rarepotato8de/RoRo60/hardware/hotswap/RoRo60HS.kicad_sch

## KiCad design hardware/hotswap/RoRo60HS.kicad_sch (2026-01-02)

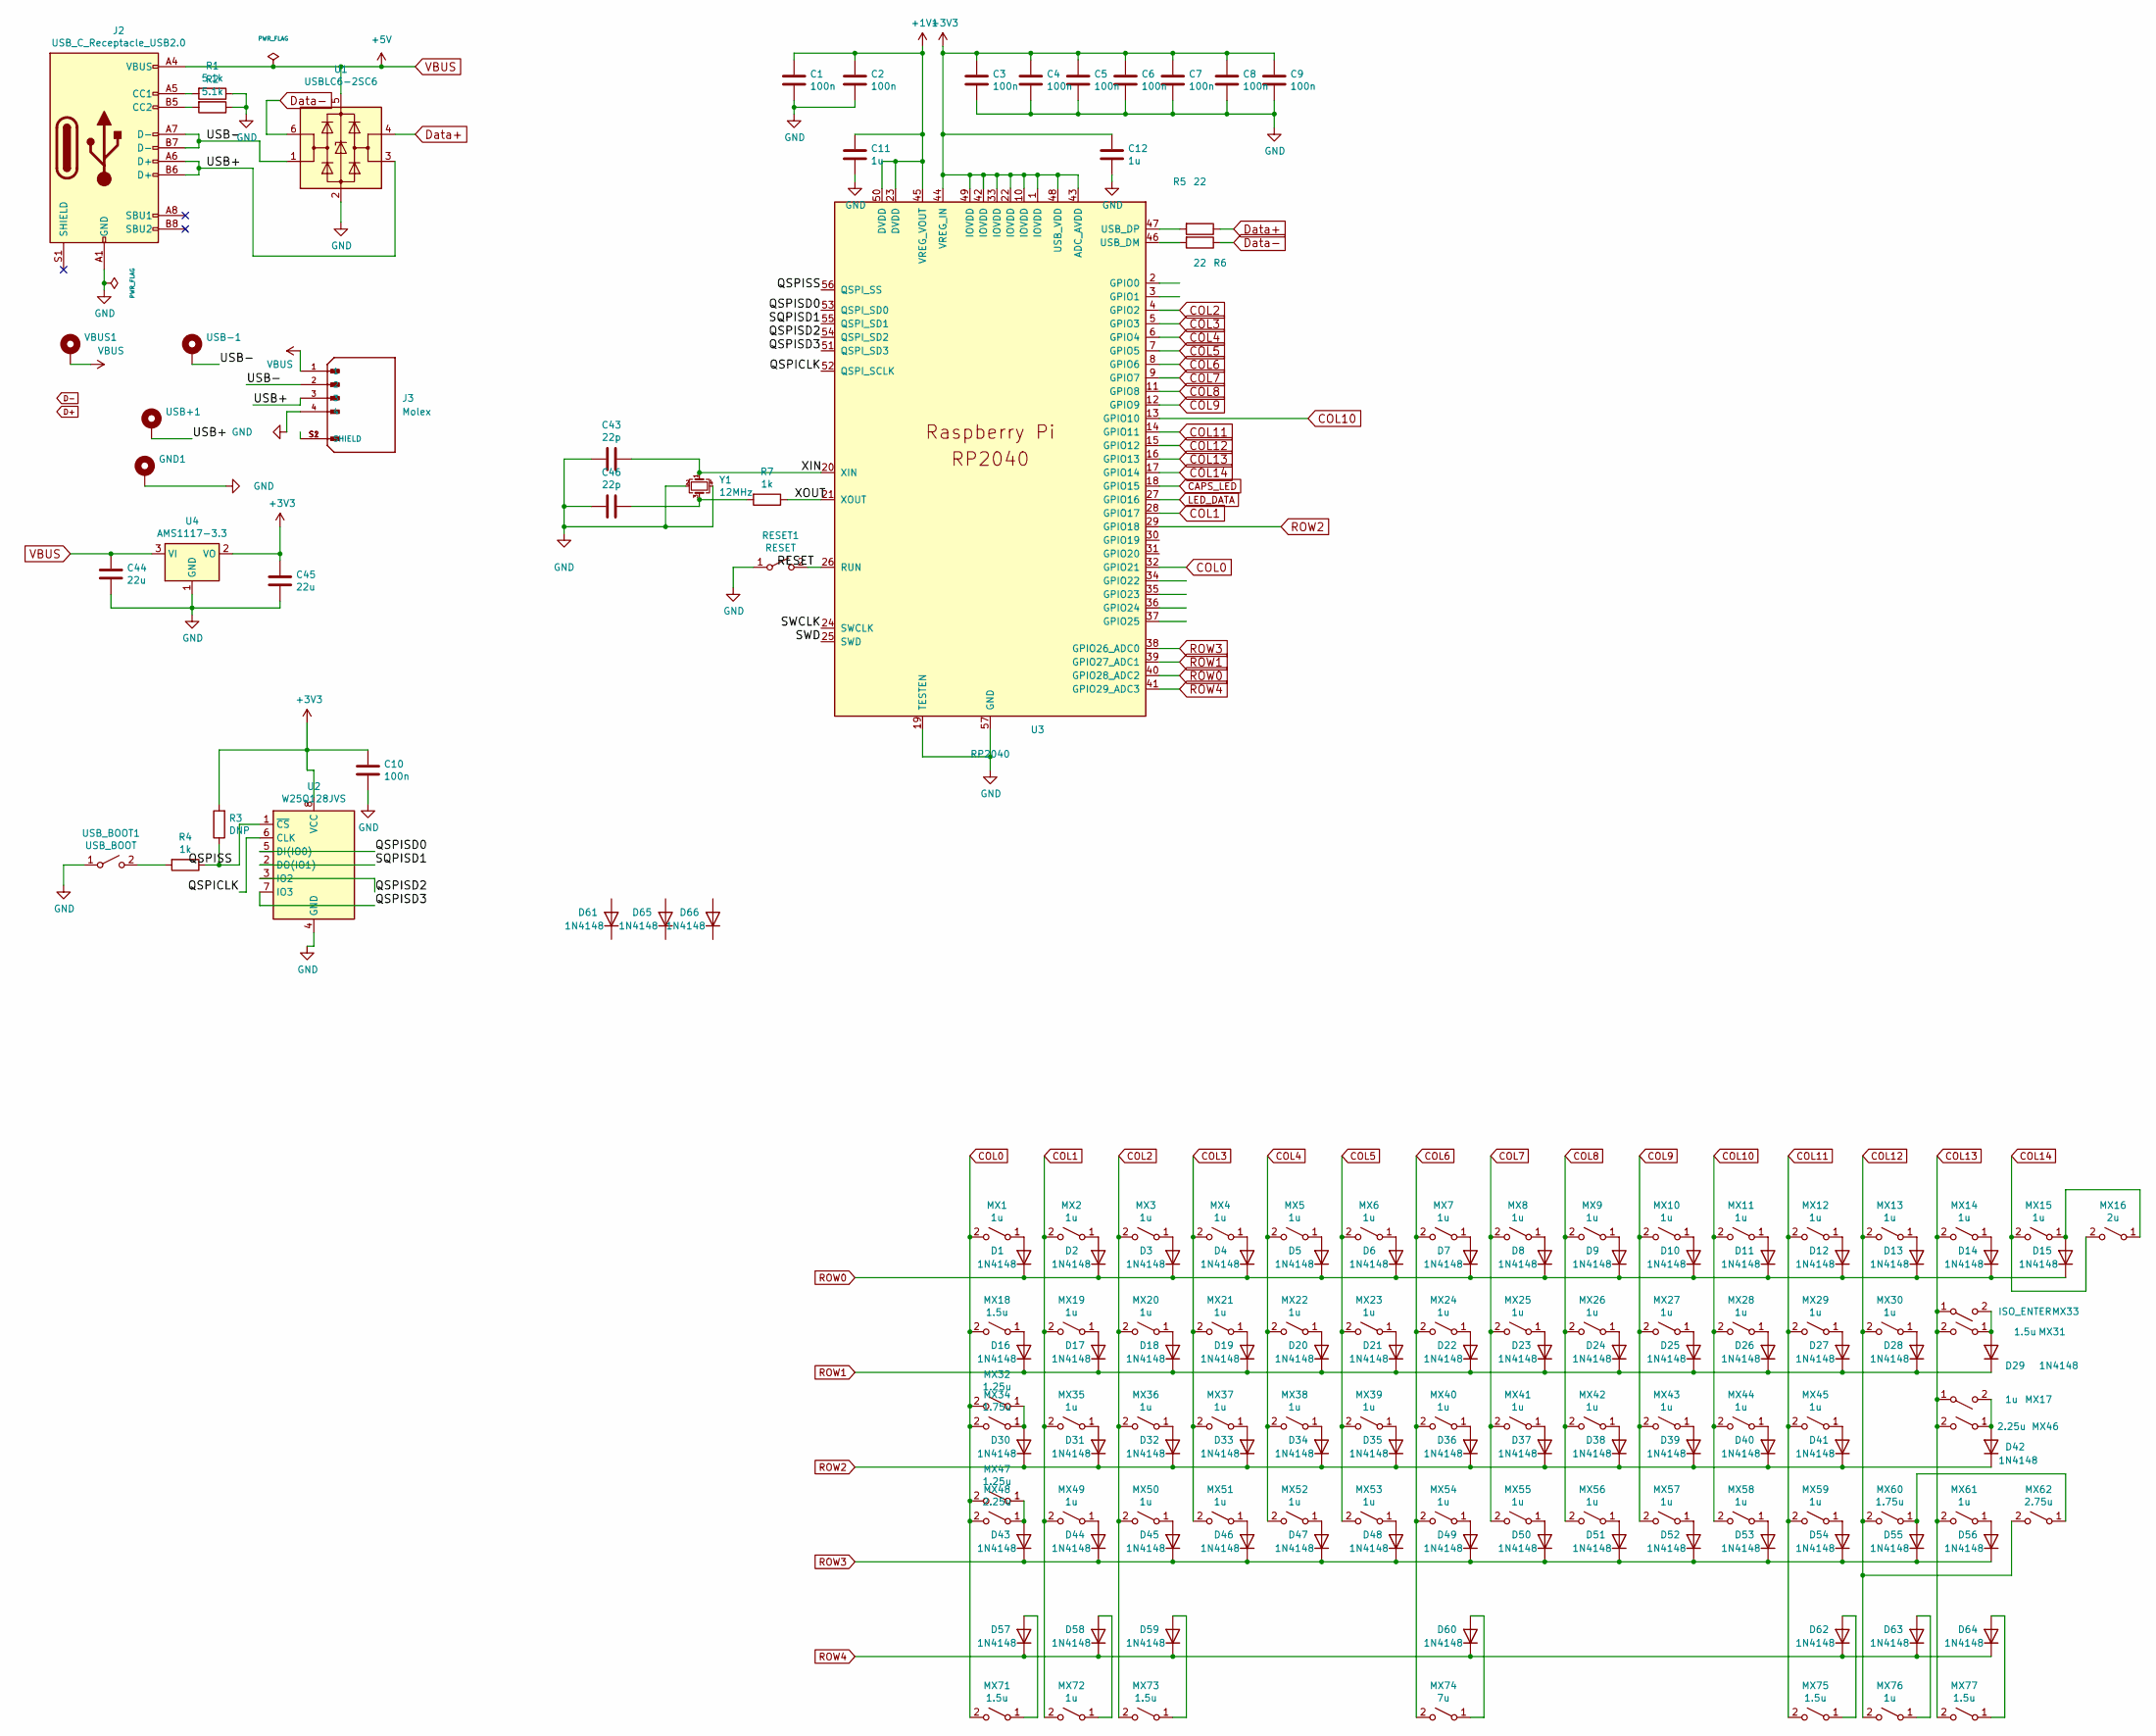
[picture p1: schematic RoRo60HS.kicad_sch]

Parts:
C1, C2, C3, C4, C5, C6, C7, C8, C9, C10: 100n; C_0603_1608Metric; LCSC C14663
C11, C12: 1u; C_0603_1608Metric; LCSC C15849
C43, C46: 22p; C_0603_1608Metric; LCSC C1653
C44, C45: 22u; C_0603_1608Metric; LCSC C59461
D1, D2, D3, D4, D5, D6, D7, D8, D9, D10, D11, D12, D13, D14, D15, D16, D17, D18, D19, D20, D21, D22, D23, D24, D25, D26, D27, D28, D29, D30, D31, D32, D33, D34, D35, D36, D37, D38, D39, D40, D41, D42, D43, D44, D45, D46, D47, D48, D49, D50, D51, D52, D53, D54, D55, D56, D57, D58, D59, D60, D61, D62, D63, D64, D65, D66: 1N4148; D_SOD-123; LCSC Part # C81598
GND1: MountingHole_Pad; SMD
J2: USB_C_Receptacle_USB2.0; USB_C_Receptacle_GCT_USB4085
J3: Molex; MOLEX_0781710004; PARTREV G
MX1, MX2, MX3, MX4, MX5, MX6, MX7, MX8, MX9, MX10, MX11, MX12, MX13, MX14, MX15, MX17, MX19, MX20, MX21, MX22, MX23, MX24, MX25, MX26, MX27, MX28, MX29, MX30, MX35, MX36, MX37, MX38, MX39, MX40, MX41, MX42, MX43, MX44, MX45, MX49, MX50, MX51, MX52, MX53, MX54, MX55, MX56, MX57, MX58, MX59, MX61, MX72, MX76: 1u; MXOnly-1U-Hotswap
MX16: 2u; MXOnly-2U-Hotswap
MX18, MX31, MX71, MX73, MX75, MX77: 1.5u; MXOnly-1.5U-Hotswap
MX32, MX47: 1.25u; MXOnly-1.25U-Hotswap
MX33: ISO_ENTER; MXOnly-ISO-Hotswap-ReversedStabilizers
MX34, MX60: 1.75u; MXOnly-1.75U-Hotswap
MX46, MX48: 2.25u; MXOnly-2.25U-Hotswap
MX62: 2.75u; MXOnly-2.75U-Hotswap
MX74: 7u; MXOnly-7U-Hotswap-ReversedStabilizers
R1, R2: 5.1k; R_0603_1608Metric; LCSC C23186
R3: DNP; R_0603_1608Metric
R4, R7: 1k; R_0603_1608Metric; LCSC C21190
R5, R6: 22; R_0603_1608Metric; LCSC C23345
RESET1: RESET; SW_SPST_TL3342; LCSC C318884
U1: USBLC6-2SC6; SOT-23-6; LCSC C558442
U2: W25Q128JVS; SOIC-8_5.23x5.23mm_P1.27mm; LCSC C97521
U3: RP2040; RP2040-QFN-56; LCSC C2040
U4: AMS1117-3.3; SOT-223-3_TabPin2; LCSC C6186
USB+1: MountingHole_Pad; SMD
USB-1: MountingHole_Pad; SMD
USB_BOOT1: USB_BOOT; SW_SPST_TL3342; LCSC C318884
VBUS1: MountingHole_Pad; SMD
Y1: 12MHz; Crystal_SMD_3225-4Pin_3.2x2.5mm; LCSC C518158

Connections:
+1V1: C1.1, C2.1, C11.1, U3.23 (DVDD), U3.45 (VREG_VOUT), U3.50 (DVDD)
+3V3: C3.1, C4.1, C5.1, C6.1, C7.1, C8.1, C9.1, C10.1, C12.1, C45.1, R3.2, U2.8 (VCC), U3.1 (IOVDD), U3.10 (IOVDD), U3.22 (IOVDD), U3.33 (IOVDD), U3.42 (IOVDD), U3.43 (ADC_AVDD), U3.44 (VREG_IN), U3.48 (USB_VDD), U3.49 (IOVDD), U4.2 (VO)
+5V: C44.1, J2.A4 (VBUS), J2.A9 (VBUS), J2.B4 (VBUS), J2.B9 (VBUS), U1.5 (VBUS), U4.3 (VI)
CAPS_LED: U3.18 (GPIO15)
COL0: MX1.2 (B), MX18.2 (B), MX32.2 (B), MX34.2 (B), MX47.2 (B), MX48.2 (B), MX71.2 (B), U3.32 (GPIO21)
COL1: MX2.2 (B), MX19.2 (B), MX35.2 (B), MX49.2 (B), MX72.2 (B), U3.28 (GPIO17)
COL2: MX3.2 (B), MX20.2 (B), MX36.2 (B), MX50.2 (B), MX73.2 (B), U3.4 (GPIO2)
COL3: MX4.2 (B), MX21.2 (B), MX37.2 (B), MX51.2 (B), U3.5 (GPIO3)
COL4: MX5.2 (B), MX22.2 (B), MX38.2 (B), MX52.2 (B), U3.6 (GPIO4)
COL5: MX6.2 (B), MX23.2 (B), MX39.2 (B), MX53.2 (B), U3.7 (GPIO5)
COL6: MX7.2 (B), MX24.2 (B), MX40.2 (B), MX54.2 (B), MX74.2 (B), U3.8 (GPIO6)
COL7: MX8.2 (B), MX25.2 (B), MX41.2 (B), MX55.2 (B), U3.9 (GPIO7)
COL8: MX9.2 (B), MX26.2 (B), MX42.2 (B), MX56.2 (B), U3.11 (GPIO8)
COL9: MX10.2 (B), MX27.2 (B), MX43.2 (B), MX57.2 (B), U3.12 (GPIO9)
COL10: MX11.2 (B), MX28.2 (B), MX44.2 (B), MX58.2 (B), U3.13 (GPIO10)
COL11: MX12.2 (B), MX29.2 (B), MX45.2 (B), MX59.2 (B), MX75.2 (B), U3.14 (GPIO11)
COL12: MX13.2 (B), MX30.2 (B), MX60.2 (B), MX62.2 (B), MX76.2 (B), U3.15 (GPIO12)
COL13: MX14.2 (B), MX17.1 (A), MX31.2 (B), MX33.1 (A), MX46.2 (B), MX61.2 (B), MX77.2 (B), U3.16 (GPIO13)
COL14: MX15.2 (B), MX16.2 (B), U3.17 (GPIO14)
Data+: R5.1, U1.4 (I/O2)
Data-: R6.1, U1.6 (I/O1)
GND: C1.2, C2.2, C3.2, C4.2, C5.2, C6.2, C7.2, C8.2, C9.2, C10.2, C11.2, C12.2, C43.2, C44.2, C45.2, C46.2, GND1.1, J2.A1 (GND), J2.A12 (GND), J2.B1 (GND), J2.B12 (GND), J3.4, R1.1, R2.1, RESET1.1 (A), U1.2 (GND), U2.4 (GND), U3.19 (TESTEN), U3.57 (GND), U4.1 (GND), USB_BOOT1.1 (A), Y1.2, Y1.4
LED_DATA: U3.27 (GPIO16)
unnamed: C46.1, R7.2, Y1.3
unnamed: D1.2 (A), MX1.1 (A)
unnamed: D2.2 (A), MX2.1 (A)
unnamed: D3.2 (A), MX3.1 (A)
unnamed: D4.2 (A), MX4.1 (A)
unnamed: D5.2 (A), MX5.1 (A)
unnamed: D6.2 (A), MX6.1 (A)
unnamed: D7.2 (A), MX7.1 (A)
unnamed: D8.2 (A), MX8.1 (A)
unnamed: D9.2 (A), MX9.1 (A)
unnamed: D10.2 (A), MX10.1 (A)
unnamed: D11.2 (A), MX11.1 (A)
unnamed: D12.2 (A), MX12.1 (A)
unnamed: D13.2 (A), MX13.1 (A)
unnamed: D14.2 (A), MX14.1 (A)
unnamed: D15.2 (A), MX15.1 (A), MX16.1 (A)
unnamed: D16.2 (A), MX18.1 (A)
unnamed: D17.2 (A), MX19.1 (A)
unnamed: D18.2 (A), MX20.1 (A)
unnamed: D19.2 (A), MX21.1 (A)
unnamed: D20.2 (A), MX22.1 (A)
unnamed: D21.2 (A), MX23.1 (A)
unnamed: D22.2 (A), MX24.1 (A)
unnamed: D23.2 (A), MX25.1 (A)
unnamed: D24.2 (A), MX26.1 (A)
unnamed: D25.2 (A), MX27.1 (A)
unnamed: D26.2 (A), MX28.1 (A)
unnamed: D27.2 (A), MX29.1 (A)
unnamed: D28.2 (A), MX30.1 (A)
unnamed: D29.2 (A), MX31.1 (A), MX33.2 (B)
unnamed: D30.2 (A), MX32.1 (A), MX34.1 (A)
unnamed: D31.2 (A), MX35.1 (A)
unnamed: D32.2 (A), MX36.1 (A)
unnamed: D33.2 (A), MX37.1 (A)
unnamed: D34.2 (A), MX38.1 (A)
unnamed: D35.2 (A), MX39.1 (A)
unnamed: D36.2 (A), MX40.1 (A)
unnamed: D37.2 (A), MX41.1 (A)
unnamed: D38.2 (A), MX42.1 (A)
unnamed: D39.2 (A), MX43.1 (A)
unnamed: D40.2 (A), MX44.1 (A)
unnamed: D41.2 (A), MX45.1 (A)
unnamed: D42.2 (A), MX17.2 (B), MX46.1 (A)
unnamed: D43.2 (A), MX47.1 (A), MX48.1 (A)
unnamed: D44.2 (A), MX49.1 (A)
unnamed: D45.2 (A), MX50.1 (A)
unnamed: D46.2 (A), MX51.1 (A)
unnamed: D47.2 (A), MX52.1 (A)
unnamed: D48.2 (A), MX53.1 (A)
unnamed: D49.2 (A), MX54.1 (A)
unnamed: D50.2 (A), MX55.1 (A)
unnamed: D51.2 (A), MX56.1 (A)
unnamed: D52.2 (A), MX57.1 (A)
unnamed: D53.2 (A), MX58.1 (A)
unnamed: D54.2 (A), MX59.1 (A)
unnamed: D55.2 (A), MX60.1 (A), MX62.1 (A)
unnamed: D56.2 (A), MX61.1 (A)
unnamed: D57.2 (A), MX71.1 (A)
unnamed: D58.2 (A), MX72.1 (A)
unnamed: D59.2 (A), MX73.1 (A)
unnamed: D60.2 (A), MX74.1 (A)
unnamed: D62.2 (A), MX75.1 (A)
unnamed: D63.2 (A), MX76.1 (A)
unnamed: D64.2 (A), MX77.1 (A)
unnamed: J2.A5 (CC1), R1.2
unnamed: J2.B5 (CC2), R2.2
unnamed: J3.S1 (SHIELD), J3.S2 (SHIELD)
unnamed: R4.2, USB_BOOT1.2 (B)
unnamed: R5.2, U3.47 (USB_DP)
unnamed: R6.2, U3.46 (USB_DM)
QSPICLK: U2.6 (CLK), U3.52 (QSPI_SCLK)
QSPISD0: U2.5 (DI(IO0)), U3.53 (QSPI_SD0)
QSPISD2: U2.3 (IO2), U3.54 (QSPI_SD2)
QSPISD3: U2.7 (IO3), U3.51 (QSPI_SD3)
QSPISS: R3.1, R4.1, U2.1 (~CS), U3.56 (QSPI_SS)
RESET: RESET1.2 (B), U3.26 (RUN)
ROW0: D1.1 (K), D2.1 (K), D3.1 (K), D4.1 (K), D5.1 (K), D6.1 (K), D7.1 (K), D8.1 (K), D9.1 (K), D10.1 (K), D11.1 (K), D12.1 (K), D13.1 (K), D14.1 (K), D15.1 (K), U3.40 (GPIO28_ADC2)
ROW1: D16.1 (K), D17.1 (K), D18.1 (K), D19.1 (K), D20.1 (K), D21.1 (K), D22.1 (K), D23.1 (K), D24.1 (K), D25.1 (K), D26.1 (K), D27.1 (K), D28.1 (K), D29.1 (K), U3.39 (GPIO27_ADC1)
ROW2: D30.1 (K), D31.1 (K), D32.1 (K), D33.1 (K), D34.1 (K), D35.1 (K), D36.1 (K), D37.1 (K), D38.1 (K), D39.1 (K), D40.1 (K), D41.1 (K), D42.1 (K), U3.29 (GPIO18)
ROW3: D43.1 (K), D44.1 (K), D45.1 (K), D46.1 (K), D47.1 (K), D48.1 (K), D49.1 (K), D50.1 (K), D51.1 (K), D52.1 (K), D53.1 (K), D54.1 (K), D55.1 (K), D56.1 (K), U3.38 (GPIO26_ADC0)
ROW4: D57.1 (K), D58.1 (K), D59.1 (K), D60.1 (K), D62.1 (K), D63.1 (K), D64.1 (K), U3.41 (GPIO29_ADC3)
SQPISD1: U2.2 (DO(IO1)), U3.55 (QSPI_SD1)
SWCLK: U3.24 (SWCLK)
SWD: U3.25 (SWD)
USB+: J2.A6 (D+), J2.B6 (D+), J3.3, U1.3 (I/O2), USB+1.1
USB-: J2.A7 (D-), J2.B7 (D-), J3.2, U1.1 (I/O1), USB-1.1
VBUS: J3.1, VBUS1.1
XIN: C43.1, U3.20 (XIN), Y1.1
XOUT: R7.1, U3.21 (XOUT)
