rarepotato8de/RoRo60/firmware/v1_underglow/config.h

#pragma once

#include "config_common.h"

/* key matrix size */
#define MATRIX_ROWS 5
#define MATRIX_COLS 15
// ROWS: Top to bottom, COLS: Left to right

#define MATRIX_ROW_PINS { GP28, GP27, GP18, GP26, GP29 }
#define MATRIX_COL_PINS { GP21, GP17, GP2, GP3, GP4, GP5, GP6, GP7, GP8, GP9, GP10, GP11, GP12, GP13, GP14 }

#define RGB_DI_PIN GP16
#define RGBLED_NUM 10
#define WS2812_PIO_USE_PIO1
#define RGBLIGHT_EFFECT_BREATHING
#define RGBLIGHT_EFFECT_RAINBOW_MOOD
#define RGBLIGHT_EFFECT_RAINBOW_SWIRL
#define RGBLIGHT_EFFECT_STATIC_GRADIENT

/* COL2ROW or ROW2COL */
#define DIODE_DIRECTION COL2ROW

/* define if matrix has ghost */
//#define MATRIX_HAS_GHOST

/* Set 0 if debouncing isn't needed */
#define DEBOUNCE 5
