rarepotato8de/RoRo60/(commit log)

2026-01-02 hotswap kicad files
    [BOM-roro60hs.csv, RoRo60HS.kicad_sch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]
2026-01-02 firmwares
    for both SOLDER AND HOTSWAP. PINOUT DIDNT CHANGE WITHIN THESE VERSIONS!
    V1 can do only do underglow, V2 can only do capslock indicator led. Only "working" for solder version since hotswap doesn't have ANY LEDs.
    But the firmwares are still correct for the hotswap version, just without LED feature.
    [config.h]
